mprosk/midi_channel_splitter/README.md

# MIDI Channel Splitter
Splits a MIDI connection into separate channels

Designed for installation into Hammond Mfg. 1455L801BK extruded enclosure

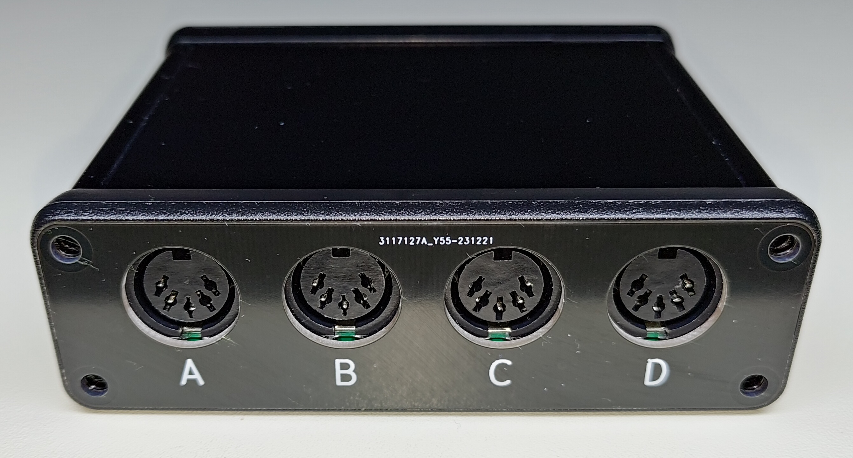
[picture p1: img/front.jpg]
front


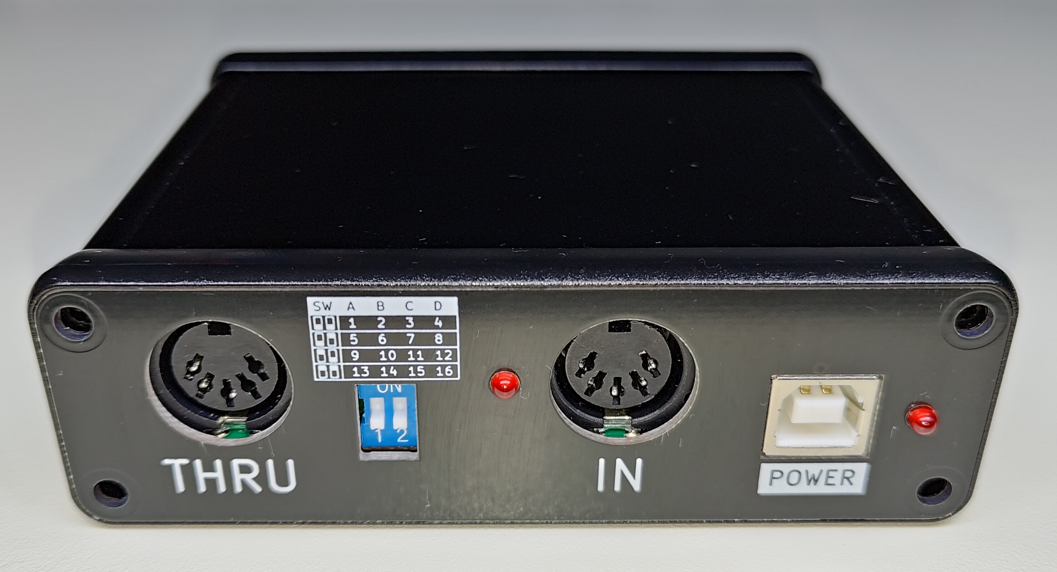
[picture p2: img/back.jpg]
back
