mprosk/midi_channel_splitter/sim/filter.asc

C1: cap; 1µ
C2: cap; 1µ
C3: cap; 10µ
C4: cap; 10µ
L1: FerriteBead; 3.3µ; Ipk=0.6 Rser=0.23 Rpar=1050 Cpar=680f mfg="Würth Elektronik" pn="742792662 WE-CBF 0603"
L2: FerriteBead; 3.3µ; Ipk=0.6 Rser=0.23 Rpar=1050 Cpar=680f mfg="Würth Elektronik" pn="742792662 WE-CBF 0603"
V1: voltage; ""; AC 1.
Named nets: 0, IN, OUT1, OUT2
.ac dec 10 1 100Meg
