mprosk/midi_channel_splitter/sim/pnp.asc

D1: LED
Q1: pnp; 2N3906
R1: res; 1k
R2: res; 1k
V1: voltage; PULSE(5 0 0 1n 1n .1 1)
V2: voltage; 5
Named nets: 0, OUT
.tran 3
