mprosk/midi_channel_splitter/sim/powerup.asc

C1: cap; 100n
C2: cap; 100n
C3: cap; 10µ
D1: schottky; 1N5817
D2: schottky; 1N5817
R1: res; 1
R2: res; 1
V1: voltage; 5
V2: voltage; PULSE(0 -9 0.1 1u 1u 0.1)
Named nets: 0, VUSB, VBarrel, Vsum
.tran 0.2
