mprosk/midi_channel_splitter/channel_splitter/channel_splitter.kicad_pcb

## KiCad design channel_splitter/channel_splitter.kicad_pcb (2024-01-10)

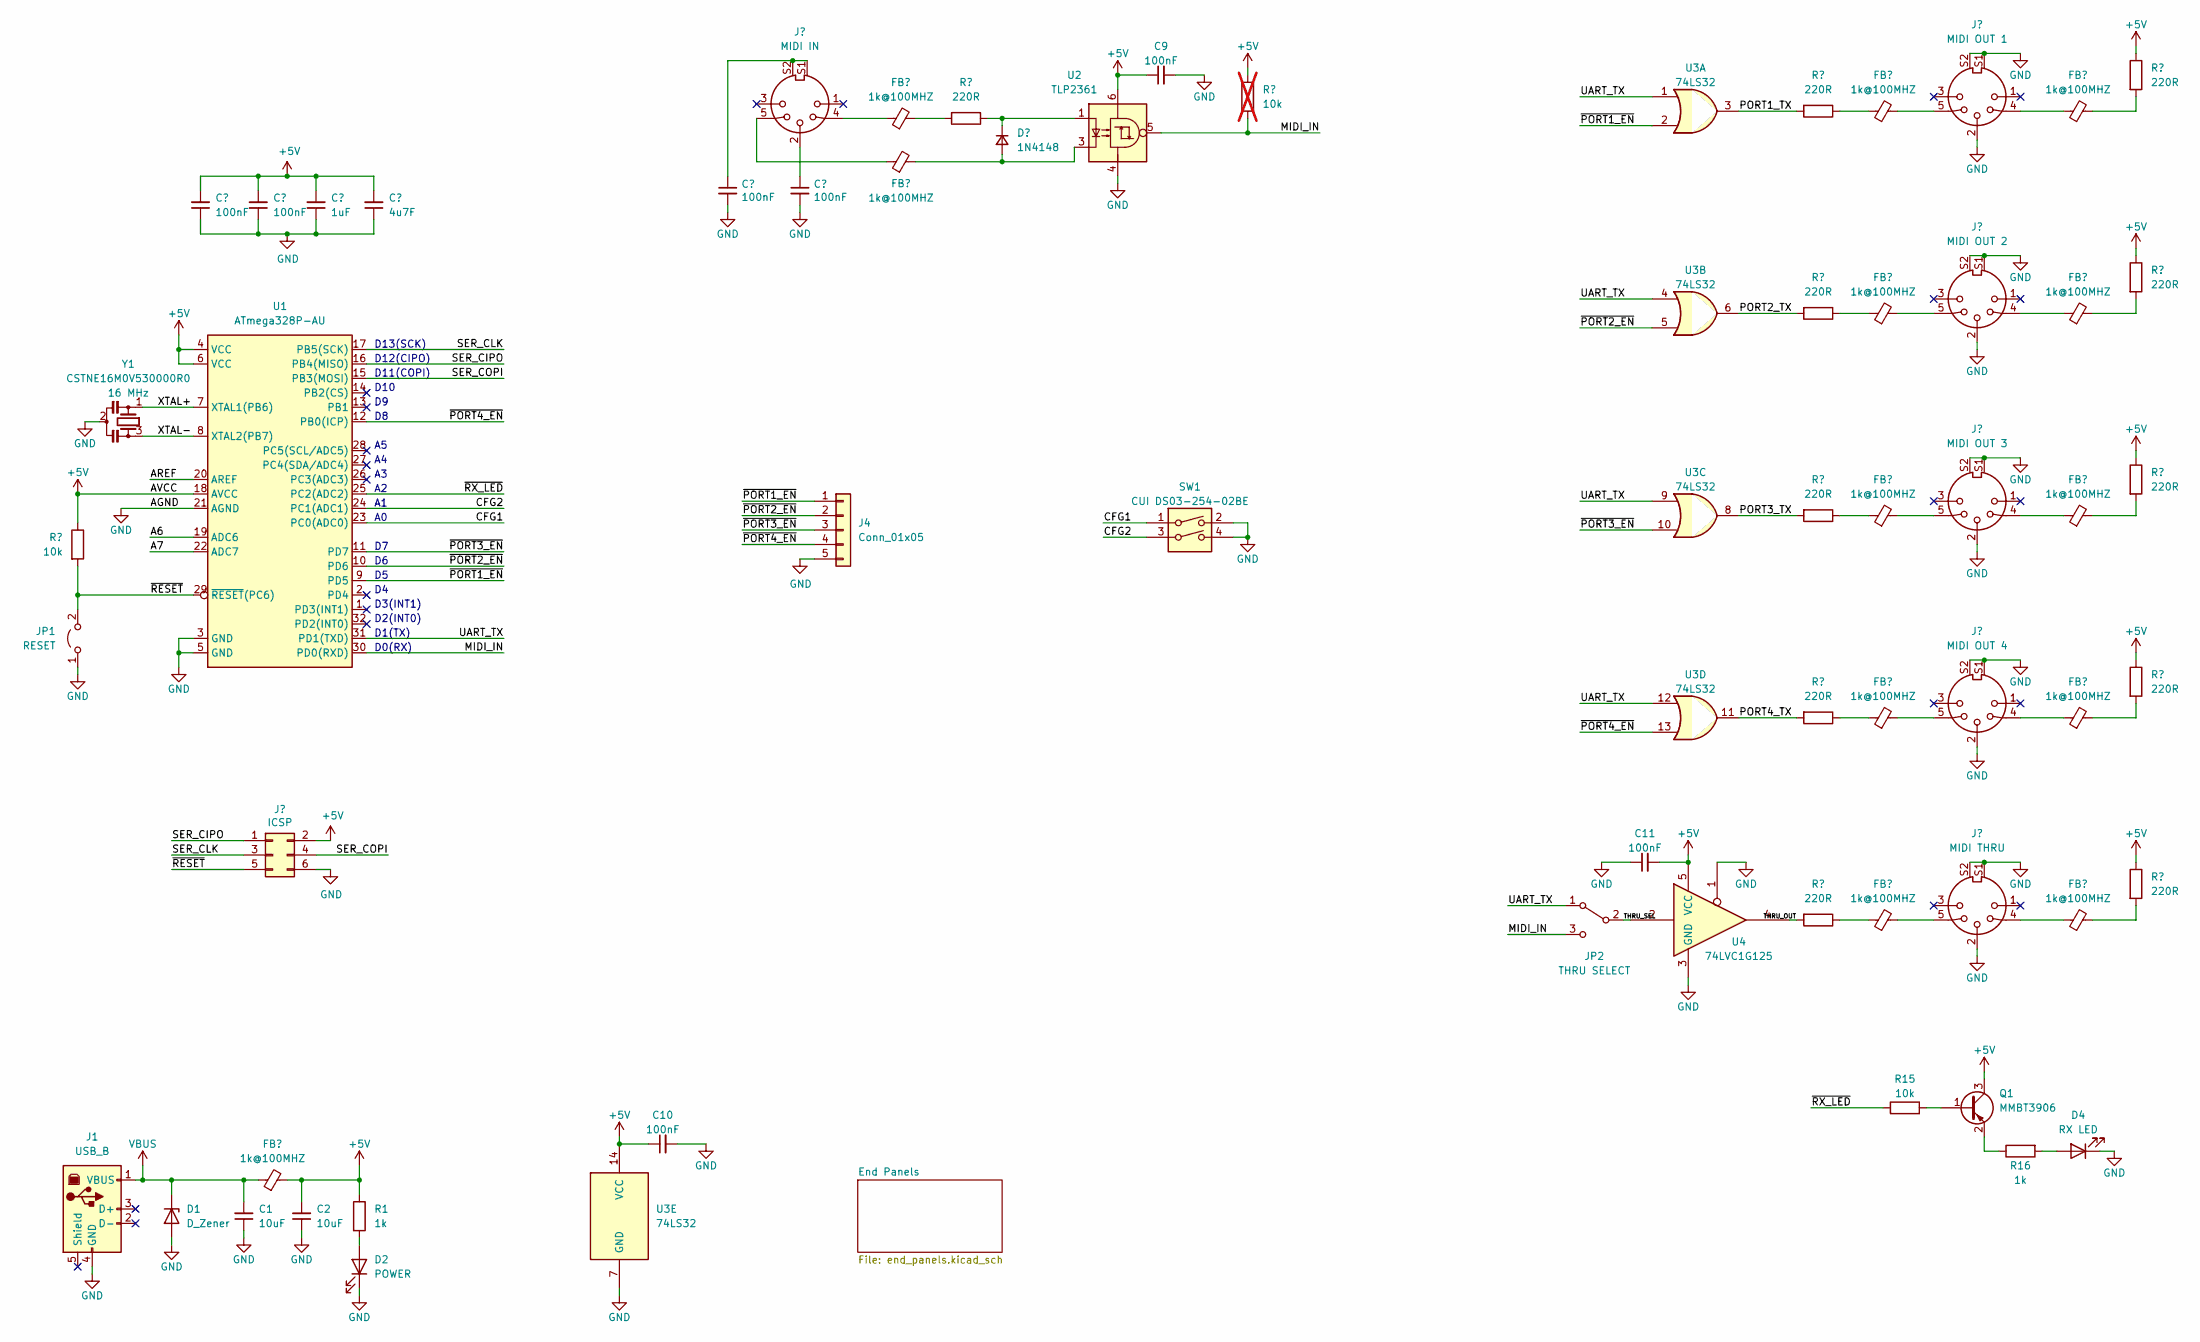
[picture p3: schematic channel_splitter.kicad_sch]

Parts:
C1, C2: 10uF; C_0805_2012Metric
C3, C4, C7, C8, C9, C10, C11: 100nF; C_0805_2012Metric
C5: 1uF; C_0805_2012Metric
C6: 4u7F; C_0805_2012Metric
D1: D_Zener; D_SOD-123
D2: POWER; LED_D3.0mm_Horizontal_O1.27mm_Z6.0mm
D3: 1N4148; D_SOD-123
D4: RX LED; LED_D3.0mm_Horizontal_O1.27mm_Z10.0mm
FB1, FB2, FB3, FB4, FB5, FB6, FB7, FB8, FB9, FB10, FB11, FB12, FB13: 1k@100MHZ; L_0805_2012Metric
J1: USB_B; USB_B_OST_USB-B1HSxx_Horizontal
J2: MIDI IN; CUI_SDS-50J
J3: ICSP; Tag-Connect_TC2030-IDC-NL_2x03_P1.27mm_Vertical
J4: Conn_01x05; PinHeader_1x05_P2.54mm_Vertical
J5: MIDI OUT 1; CUI_SDS-50J
J6: MIDI OUT 2; CUI_SDS-50J
J7: MIDI OUT 3; CUI_SDS-50J
J8: MIDI OUT 4; CUI_SDS-50J
J9: MIDI THRU; CUI_SDS-50J
JP1: RESET; PinHeader_1x02_P2.54mm_Vertical
JP2: THRU SELECT; PinHeader_1x03_P2.54mm_Vertical
Q1: MMBT3906; SOT-23
R1, R16: 1k; R_0805_2012Metric
R2, R15: 10k; R_0805_2012Metric
R3, R5, R6, R7, R8, R9, R10, R11, R12, R13, R14: 220R; R_0805_2012Metric
R4: 10k; R_0805_2012Metric; not fitted
SW1: CUI DS03-254-02BE; SW_DIP_CUI_DS03-254-02BE
U1: ATmega328P-AU; TQFP-32_7x7mm_P0.8mm
U2: TLP2361; SO-5_4.4x3.6mm_P1.27mm
U3: 74LS32; SOIC-14_3.9x8.7mm_P1.27mm
U4: 74LVC1G125; SOT-23-5
Y1: CSTNE16M0V530000R0; Resonator_SMD_Murata_CSTxExxV-3Pin_3.0x1.1mm

Connections:
+5V: C2.2, C3.2, C4.2, C5.2, C6.2, C9.1, C10.1, C11.2, FB1.2, J3.2, Q1.3 (C), R1.1, R2.1, R4.1, R6.1, R8.1, R10.1, R12.1, R14.1, U1.4 (VCC), U1.6 (VCC), U1.18 (AVCC), U2.6, U3.14 (VCC), U4.5 (VCC)
/A6: U1.19 (ADC6)
/A7: U1.22 (ADC7)
/AREF: U1.20 (AREF)
/CFG1: SW1.1, U1.23 (PC0(ADC0))
/CFG2: SW1.3, U1.24 (PC1(ADC1))
/MIDI_IN: JP2.3 (C), R4.2, U1.30 (PD0(RXD)), U2.5
/PORT1_TX: R5.2, U3.3
/PORT2_TX: R7.2, U3.6
/PORT3_TX: R9.2, U3.8
/PORT4_TX: R11.2, U3.11
/SER_CIPO: J3.1, U1.16 (PB4(MISO))
/SER_CLK: J3.3, U1.17 (PB5(SCK))
/SER_COPI: J3.4, U1.15 (PB3(MOSI))
/THRU_OUT: R13.2, U4.4
/THRU_SEL: JP2.2 (B), U4.2
/UART_TX: JP2.1 (A), U1.31 (PD1(TXD)), U3.1, U3.4, U3.9, U3.12
/XTAL+: U1.7 (XTAL1(PB6)), Y1.1
/XTAL-: U1.8 (XTAL2(PB7)), Y1.3
/~PORT1_EN: J4.1, U1.9 (PD5), U3.2
/~PORT2_EN: J4.2, U1.10 (PD6), U3.5
/~PORT3_EN: J4.3, U1.11 (PD7), U3.10
/~PORT4_EN: J4.4, U1.12 (PB0(ICP)), U3.13
/~RESET: J3.5, JP1.2 (B), R2.2, U1.29 (~RESET(PC6))
/~RX_LED: R15.1, U1.25 (PC2(ADC2))
GND: C1.1, C2.1, C3.1, C4.1, C5.1, C6.1, C7.2, C8.2, C9.2, C10.2, C11.1, D1.2 (A), D2.1 (K), D4.1 (K), J1.4 (GND), J3.6, J4.5, J5.2, J5.S1, J5.S2, J6.2, J6.S1, J6.S2, J7.2, J7.S1, J7.S2, J8.2, J8.S1, J8.S2, J9.2, J9.S1, J9.S2, JP1.1 (A), SW1.2, SW1.4, U1.3 (GND), U1.5 (GND), U1.21 (AGND), U2.4, U3.7 (GND), U4.1, U4.3 (GND), Y1.2
unnamed: C7.1, J2.S1, J2.S2
unnamed: C8.1, J2.2
unnamed: D2.2 (A), R1.2
unnamed: D3.2 (A), FB3.2, U2.3
unnamed: D3.1 (K), R3.1, U2.1
unnamed: D4.2 (A), R16.2
unnamed: FB2.1, J2.4
unnamed: FB2.2, R3.2
unnamed: FB3.1, J2.5
unnamed: FB4.1, R5.1
unnamed: FB4.2, J5.5
unnamed: FB5.1, J5.4
unnamed: FB5.2, R6.2
unnamed: FB6.1, R7.1
unnamed: FB6.2, J6.5
unnamed: FB7.1, J6.4
unnamed: FB7.2, R8.2
unnamed: FB8.1, R9.1
unnamed: FB8.2, J7.5
unnamed: FB9.1, J7.4
unnamed: FB9.2, R10.2
unnamed: FB10.1, R11.1
unnamed: FB10.2, J8.5
unnamed: FB11.1, J8.4
unnamed: FB11.2, R12.2
unnamed: FB12.1, R13.1
unnamed: FB12.2, J9.5
unnamed: FB13.1, J9.4
unnamed: FB13.2, R14.2
unnamed: Q1.1 (B), R15.2
unnamed: Q1.2 (E), R16.1
VBUS: C1.2, D1.1 (K), FB1.1, J1.1 (VBUS)

Notes on the sheet:
D12(CIPO)
D1(TX)
D3(INT1)
D11(COPI)
D0(RX)
D13(SCK)
D10
D2(INT0)

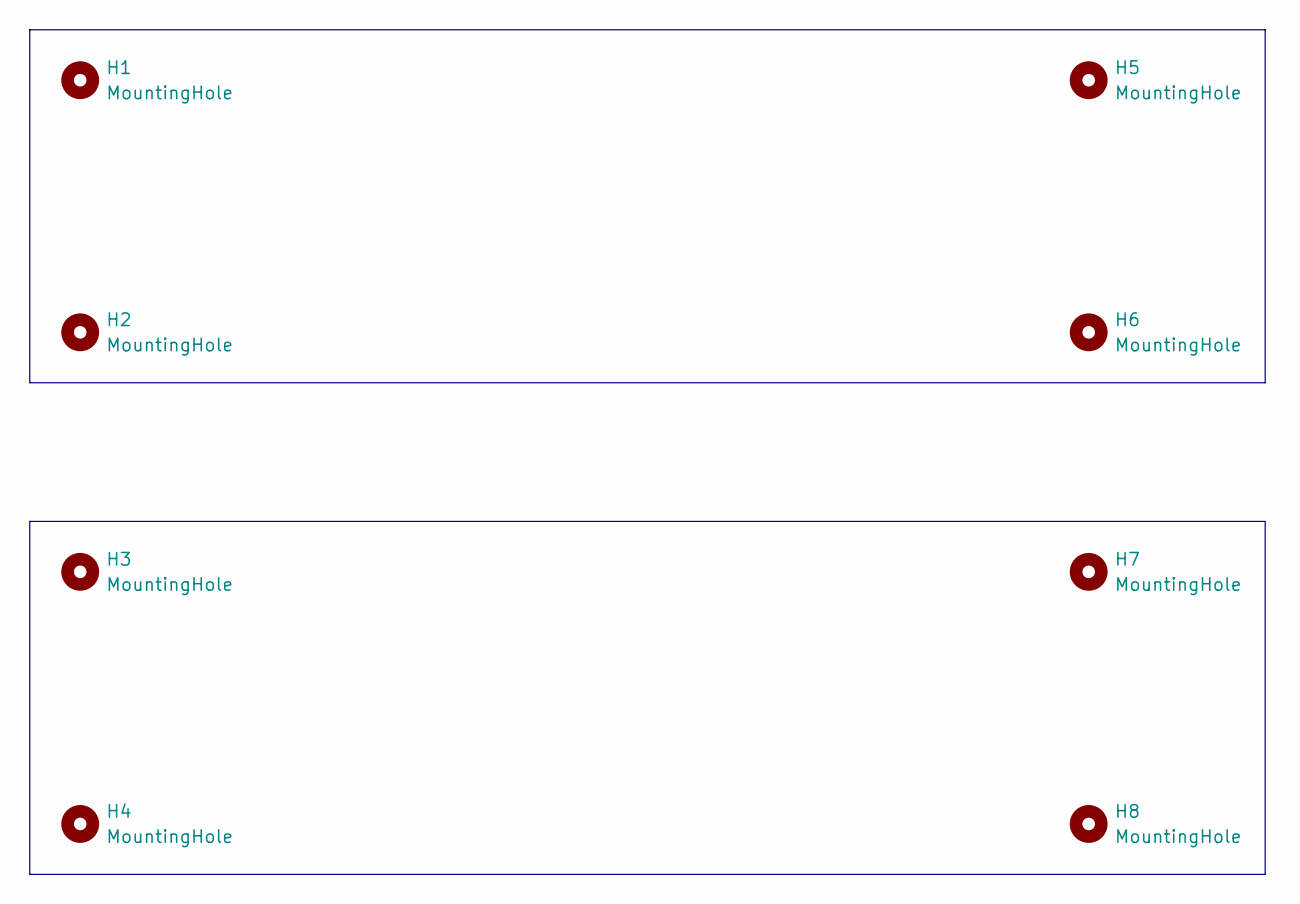
[picture p4: schematic end_panels.kicad_sch]

Parts:
H1, H2, H3, H4, H5, H6, H7, H8: MountingHole; Hammond_1455_End_Plate_Hole

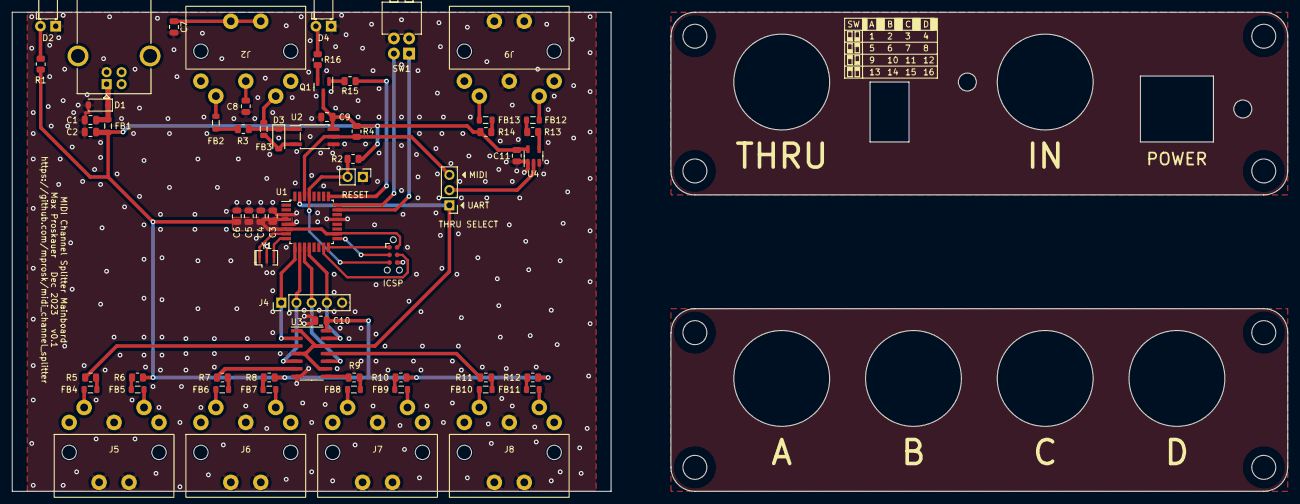
[picture p5: board channel_splitter.kicad_pcb from above]

Board: 2 copper layers, 100.0 x 80.0 mm, 70 parts (0 on the bottom side), 55 nets.
