mprosk/midi_channel_splitter/(commit log)

2023-12-18 Get first pass schematic and layout
    [channel_splitter.kicad_pcb, channel_splitter.kicad_sch, end_panels.kicad_sch, power_supply.kicad_sch]
2023-12-18 Add gerbers
    [channel_splitter-B_Cu.gbr, channel_splitter-B_Mask.gbr, channel_splitter-B_Paste.gbr, channel_splitter-B_Silkscreen.gbr, channel_splitter-Edge_Cuts.gbr, channel_splitter-F_Cu.gbr, channel_splitter-F_Mask.gbr, channel_splitter-F_Paste.gbr]
2023-12-18 Add version info to silkscreen. update gerbers
    [channel_splitter-B_Cu.gbr, channel_splitter-B_Mask.gbr, channel_splitter-B_Paste.gbr, channel_splitter-B_Silkscreen.gbr, channel_splitter-Edge_Cuts.gbr, channel_splitter-F_Cu.gbr, channel_splitter-F_Mask.gbr, channel_splitter-F_Paste.gbr]
2024-01-10 Misc local changes
    [channel_splitter.kicad_pcb, channel_splitter.kicad_sch, end_panels.kicad_sch]
